AnvithPothula/HalfLifeWeek4-Displays/DeskDashboard/production/bom.csv

Designator | Footprint | Quantity | Value | LCSC Part #
C1 | 0805 | 1 | 10u
J1 | PinHeader_1x08_P2.54mm_Vertical | 1 | Conn_01x08
Q1 | SOT-23 | 1 | AO3401A
R1 | R_Axial_DIN0207_L6.3mm_D2.5mm_P10.16mm_Horizontal | 1 | 10k
SW1 | RotaryEncoder_Alps_EC11E-Switch_Vertical_H20mm | 1 | RotaryEncoder_Switch
U1 | Waveshare ESP32-S3-Zero | 1 | Waveshare ESP32-S3-ZERO
