AnvithPothula/HalfLifeWeek4-Displays/JOURNAL.md

# Desk Dashboard: devlog

<!-- Generated by Half Life from project j37hs4uu8ih0fjrtpx7ralbj. Edits here are overwritten on the next sync. -->
<!-- Generated: 2026-11-02T02:35:15.616Z -->

> [!NOTE]
> This devlog is mirrored from [Half Life](https://halflife.hackclub.com) ([open the project](https://halflife.hackclub.com/projects/j37hs4uu8ih0fjrtpx7ralbj)). Editing it here will not change the platform's copy, and the next sync overwrites this file.

> A small desk screen that pulls live data over Wi-Fi and shows it on a 2" colour TFT. You will be able to interact with the screen with an encoder (turn it to switch pages and press it to do an action).

| Week | Tier | Hours logged | Entries |
| --- | --- | --- | --- |
| Week 4 | Tier 1 | 15h | 4 |

## Contents

1. [2026-10-31: In this session I finished the schematic of my project. It wasn't too complicated, but it was my first time making a project schematic without a guide. In total, there is an ESP32 (where everything is](#2026-10-31-in-this-session-i-finished-the-schematic-of-my-pr)
2. [2026-10-31: I finished the PCB and wiring in this session. I started with making the outline of where the screen will be and how big the PCB will be. I wanted to keep the PCB under 100m x 100m, and I settled with](#2026-10-31-i-finished-the-pcb-and-wiring-in-this-session-i-s)
3. [2026-11-01: This session I started the firmware for the desk dashboard. I’m using Arduino with the ESP32 core, Adafruit ST7789 for the screen, and Adafruit NeoPixel for the built in LED. The plan is to have 9 pag](#2026-11-01-this-session-i-started-the-firmware-for-the-desk-)
4. [2026-11-01: Today I added the internet pages (weather, chess ratings, the lichess daily puzzle, FRC, GitHub and a quote/fun fact).](#2026-11-01-today-i-added-the-internet-pages-weather-chess-ra)

## Design

### 2026-10-31: In this session I finished the schematic of my project. It wasn't too complicated, but it was my first time making a project schematic without a guide. In total, there is an ESP32 (where everything is

**4h**

In this session I finished the schematic of my project. It wasn't too complicated, but it was my first time making a project schematic without a guide. In total, there is an ESP32 (where everything is connected to), an encoder (to change the pages and do actions on the screen), a 1x8 connector (for the screen), and an AO3401A switch for the backlight LED. This is how the final schematic turned out:

Screenshot 2026-10-30 at 9.37.29 PM

I first started with the ESP32. After running the Electrical Rules Checker, I realized that I had to add a power flag to the +3V3 and GND.

Screenshot 2026-10-30 at 9.36.43 PM

Then, I did the 1x8 connector. I also added a small capacitor to kind of act like a tiny battery in case the screen redraws.

Screenshot 2026-10-30 at 9.31.53 PM

Then, I added the AO3401A switch. This took a bit of time since I didn't really understand how it worked, but I ended up also adding a small resistor to limit the current.

Screenshot 2026-10-30 at 9.32.05 PM

Finally, I added an encoder. This was pretty simple since I used encoders in last week's project. I'm using the switch functionality along with the turning (the turning will change pages on the screen and the clicking will do an action). This is how it turned out:

Screenshot 2026-10-30 at 9.32.13 PM

Finally, I added the footprints to everything. I also decided to include some mounting holes in the end.

Screenshot 2026-10-30 at 9.53.58 PM

Next session I will finish the PCB and all the wiring.

### 2026-10-31: I finished the PCB and wiring in this session. I started with making the outline of where the screen will be and how big the PCB will be. I wanted to keep the PCB under 100m x 100m, and I settled with

**3h**

I finished the PCB and wiring in this session. I started with making the outline of where the screen will be and how big the PCB will be. I wanted to keep the PCB under 100m x 100m, and I settled with a size of 95mm x 70mm. I put the screen in the top left corner, and then put the encoder to the right of it. Then, I added everything else. I also put the mounting holes in the corners. This is how it ended up:

Screenshot 2026-10-30 at 10.33.38 PM

Then, I wired everything up:

Screenshot 2026-10-31 at 4.49.43 PM

Finally, I added a fill on the back for GND and added the 3D models:

Screenshot 2026-10-31 at 6.36.38 PM

Finally, I added designs for the silkscreen. This is the final result:

Screenshot 2026-10-31 at 6.39.28 PM

### 2026-11-01: This session I started the firmware for the desk dashboard. I’m using Arduino with the ESP32 core, Adafruit ST7789 for the screen, and Adafruit NeoPixel for the built in LED. The plan is to have 9 pag

**4h**

This session I started the firmware for the desk dashboard. I’m using Arduino with the ESP32 core, Adafruit ST7789 for the screen, and Adafruit NeoPixel for the built in LED. The plan is to have 9 pages on the screen (clock, weather, pomodoro, daily chess puzzle, chess stats, FRC, GitHub, quote/fun fact, and countdowns). Turning the encoder will change the page, and pressing it will do an action.

First I matched the pins to my schematic. The screen uses GPIO 7–12, the encoder uses GPIO 1–3, and the LED is on GPIO 21. I also made it so that each page has its own color, and the status LED changes to that colour too.

Screenshot 2026-11-01 at 2.40.15 PM

The backlight is switched by a P-MOSFET, which turns on when its gate is pulled LOW. That means the PWM value has to be inverted. I also added a BL_DIRECT setting so I can flip this back if I ever wire the backlight straight to the pin. Brightness uses ledcAttach, and if you hold the button, it turns on night mode (on most pages), which dims both the screen and the LED.

For the encoder, I decided to read both pins in an interrupt instead of checking them in loop(). The interrupt uses a lookup table that turns each change of the A and B pins into +1, −1 or 0.  Also, readEncoderClicks() divides by 4 since the EC11 gives 4 steps per click.

Screenshot 2026-11-01 at 2.40.40 PM

In loop(), clicks move the page forward or back and wrap around at both ends. I also made it so that anything under 30 ms is ignored as a bounce, and holding for over 700 ms counts as a long press. A long press only fires once per hold, so holding the button doesn’t keep toggling night mode.

Screenshot 2026-11-01 at 2.41.07 PM

Next I wrote the Pomodoro timer. It’s 25 minutes of focus and 5 minute breaks, with a 15 minute break after every 4 sessions. It has 3 states, which are idle, running and paused. When a phase ends, the LED blinks green or red and the screen jumps to the pomodoro page, even if I am on another page.

Screenshot 2026-11-01 at 2.41.34 PM

Finally, I also wrote the clock and countdown pages. The clock gets the time from an NTP server, and I made sure to also handle daylight savings. To stop flicker, it only redraws when the second changes.

Screenshot 2026-11-01 at 2.43.47 PM

I wasn't able to test any of this code since I don't have the screen, so that will be something I need to do during the build week when I have the screen.

### 2026-11-01: Today I added the internet pages (weather, chess ratings, the lichess daily puzzle, FRC, GitHub and a quote/fun fact).

**4h**

Today I added the internet pages (weather, chess ratings, the lichess daily puzzle, FRC, GitHub and a quote/fun fact).

The ESP32 doesn’t have much RAM, and some API responses are large. The lichess user API, for example, returns a lot of data I don’t need. For this problem, there is a helper function, getJson(), that every page uses. It streams the response into ArduinoJson with a filter, so only the fields I ask for are stored.

Screenshot 2026-11-01 at 7.34.26 PM

The Chess page shows my lichess and chess.com ratings side by side for bullet, blitz, rapid, and puzzles. Both sites use the same username neurochessmaster.

Screenshot 2026-11-01 at 7.35.14 PM

The Puzzle page was the hardest part. The lichess daily puzzle API gives a FEN string, so I wrote loadFen() to turn it into an 8×8 array of pieces. The FEN also says whose turn it is, so the board can flip when Black is to move.

Screenshot 2026-11-01 at 7.36.15 PM

drawBoard() draws 24-pixel squares and shows each piece as a circle with its letter on it, since the screen has no chess fonts. I made it so that the last move is highlighted in yellow. Each press of the button plays the next move of the solution (with only one encoder I can't make it so that you can actually move the pieces and solve the puzzle). applyMove() handles castling, en passant, and promotion.

Screenshot 2026-11-01 at 7.37.07 PM

To avoid spamming the APIs, only the page on screen fetches data, and each kind of data has its own refresh time (for example weather every 10 minutes, chess and GitHub every 30, the puzzle and quote every hour). A short press on any internet page forces a refresh right away. After a fetch, the page is redrawn with the new data.

Screenshot 2026-11-01 at 7.38.00 PM

The FRC page finds Team 2220’s next event and counts down the days. The Quote/fun fact page switches between zenquotes and uselessfacts. The screen’s font can’t show curly quotes or dashes, so I wrote toAscii() to swap them for plain ones.

This will probably be the last session, and I am happy with the result so far. All that's left to do is test it on the actual screen during the build week.
