AnvithPothula/HalfLifeWeek4-Displays/DeskDashboard/DeskDashboard.kicad_pcb

## KiCad design DeskDashboard/DeskDashboard.kicad_pcb (2026-11-02)

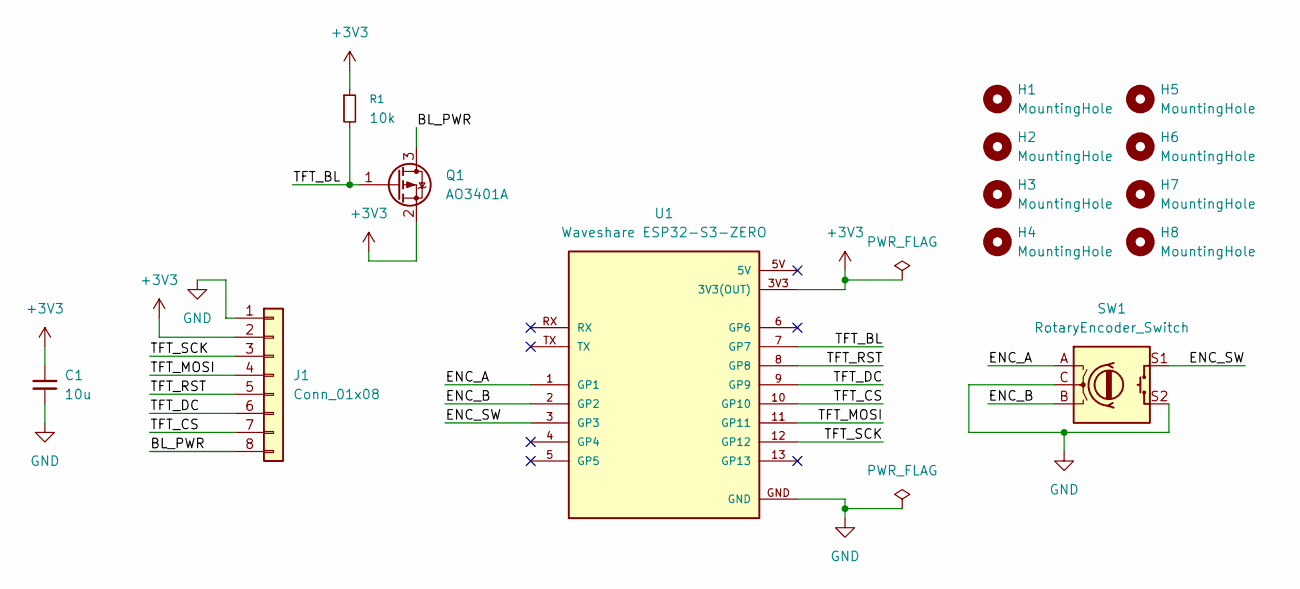
[picture p6: schematic DeskDashboard.kicad_sch]

Parts:
C1: 10u; C_0805_2012Metric
H1, H2, H3, H4: MountingHole; MountingHole_2.7mm_M2.5
H5, H6, H7, H8: MountingHole; MountingHole_3.2mm_M3
J1: Conn_01x08; PinHeader_1x08_P2.54mm_Vertical
Q1: AO3401A; SOT-23
R1: 10k; R_Axial_DIN0207_L6.3mm_D2.5mm_P10.16mm_Horizontal
SW1: RotaryEncoder_Switch; RotaryEncoder_Alps_EC11E-Switch_Vertical_H20mm
U1: Waveshare ESP32-S3-ZERO; Waveshare ESP32-S3-Zero; PARTREV NA

Connections:
+3V3: C1.1, J1.2, Q1.2 (S), R1.1, U1.3V3 (3V3(OUT))
/BL_PWR: J1.8, Q1.3 (D)
/ENC_A: SW1.A, U1.1 (GP1)
/ENC_B: SW1.B, U1.2 (GP2)
/ENC_SW: SW1.S1, U1.3 (GP3)
/TFT_BL: Q1.1 (G), R1.2, U1.7 (GP7)
/TFT_CS: J1.7, U1.10 (GP10)
/TFT_DC: J1.6, U1.9 (GP9)
/TFT_MOSI: J1.4, U1.11 (GP11)
/TFT_RST: J1.5, U1.8 (GP8)
/TFT_SCK: J1.3, U1.12 (GP12)
GND: C1.2, J1.1, SW1.C, SW1.S2, U1.GND

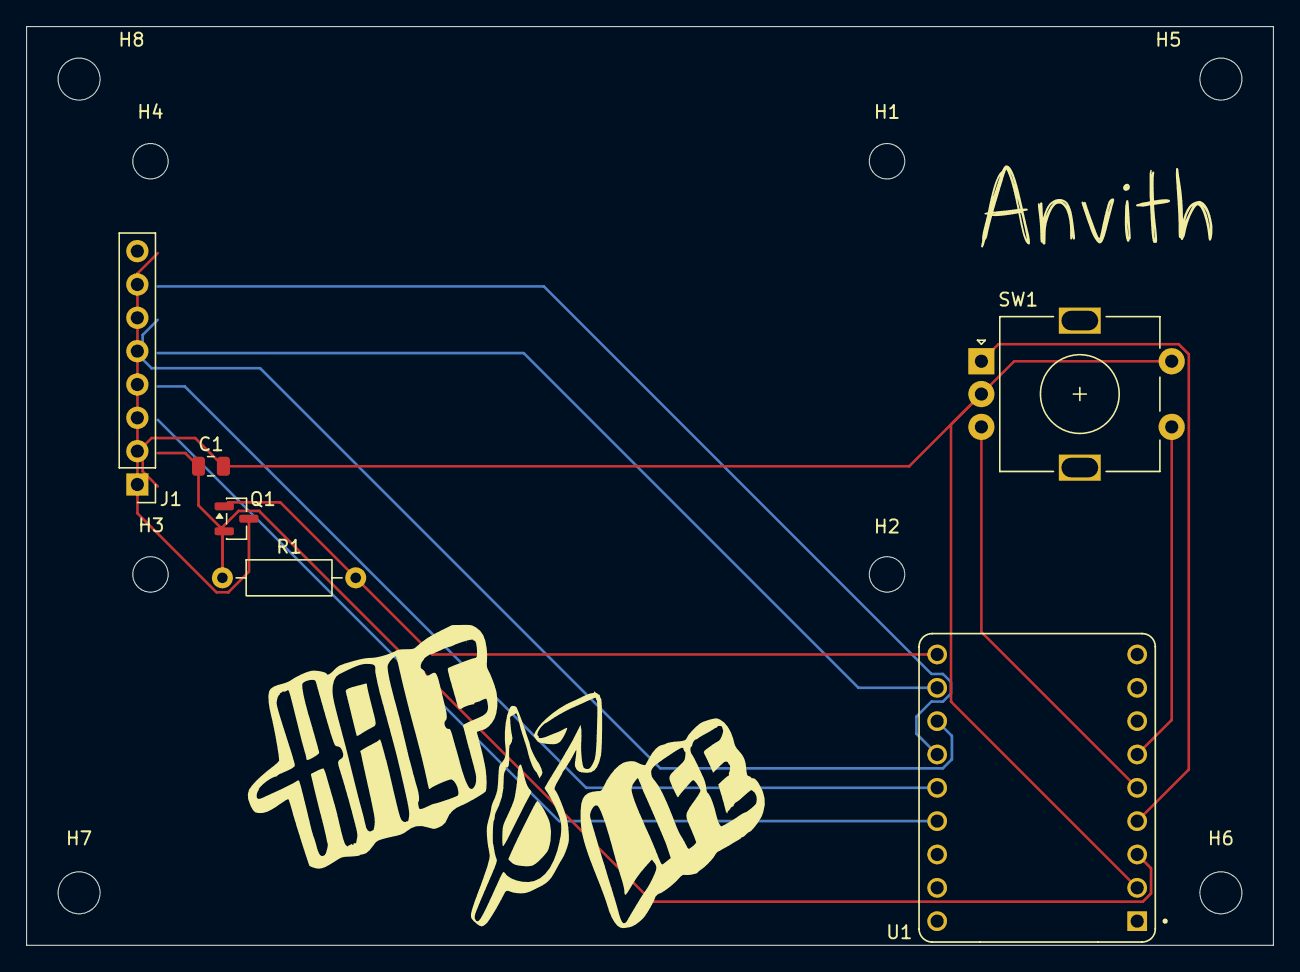
[picture p7: board DeskDashboard.kicad_pcb from above]

Board: 2 copper layers, 95.0 x 70.0 mm, 14 parts (0 on the bottom side), 12 nets.
