AnvithPothula/HalfLifeWeek4-Displays/(commit log)

2026-10-26 Sync Displays from Half Life
    [BOM.csv]
2026-11-02 Finished week 4
    [DeskDashboard.kicad_pcb, DeskDashboard.kicad_sch, bom.csv, designators.csv, positions.csv]
2026-11-02 Sync Desk Dashboard from Half Life
    [BOM.csv]
2026-11-02 Updated BOM in README
2026-11-10 Updated BOM
    [BOM.csv]
2026-11-12 Revert "Updated BOM"
    This reverts commit deb5b8164f51bc085ce9db17e2c3ba8aff3a1bd0.
    [BOM.csv]
